byungyoonc/Technik-MIT/Technik-MIT/Technik-MIT.kicad_pcb

## KiCad design Technik-MIT/Technik-MIT.kicad_pcb (2023-05-11)

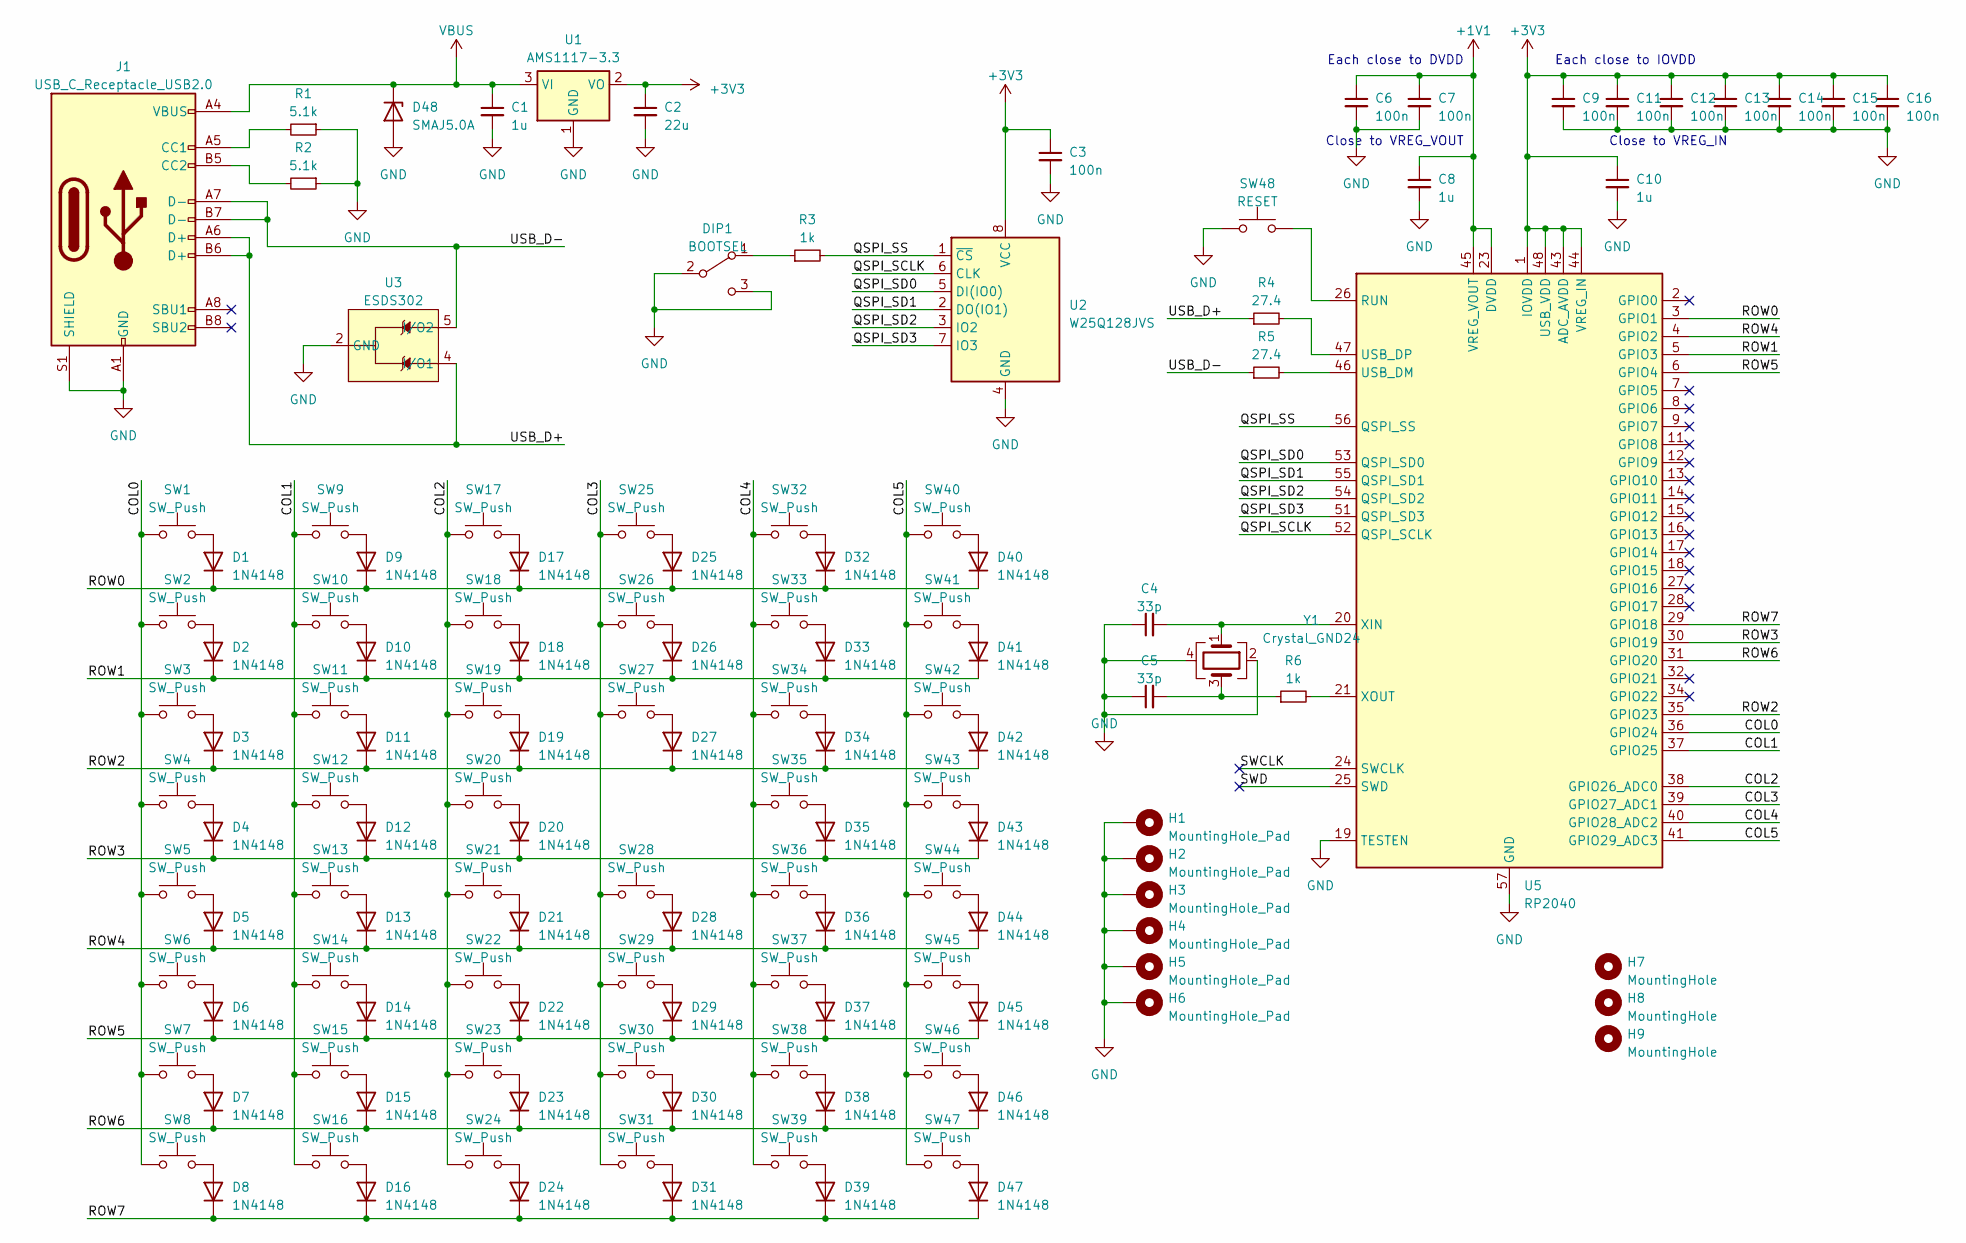
[picture p1: schematic Technik-MIT.kicad_sch]

Parts:
C1, C8, C10: 1u; C_0402_1005Metric
C2: 22u; C_0603_1608Metric
C3, C6, C7, C9, C11, C12, C13, C14, C15, C16: 100n; C_0402_1005Metric
C4, C5: 33p; C_0402_1005Metric
D1, D2, D3, D4, D5, D6, D7, D8, D9, D10, D11, D12, D13, D14, D15, D16, D17, D18, D19, D20, D21, D22, D23, D24, D25, D26, D27, D28, D29, D30, D31, D32, D33, D34, D35, D36, D37, D38, D39, D40, D41, D42, D43, D44, D45, D46, D47: 1N4148; D_SOD-123
D48: SMAJ5.0A; D_SMA; LCSC C2925443
DIP1: BOOTSEL; SW_SPDT_PCM12; LCSC C431541
H1, H2, H3, H4, H5, H6: MountingHole_Pad; Standoff_Hole
H7, H8, H9: MountingHole; Tooling Hole
J1: USB_C_Receptacle_USB2.0; Molex-216990_GCT-USB45xx_HRO-TYPE-C-31-M-13x; LCSC C3019717
R1, R2: 5.1k; R_0402_1005Metric
R3, R6: 1k; R_0402_1005Metric
R4, R5: 27.4; R_0603_1608Metric
SW1, SW2, SW3, SW4, SW5, SW6, SW7, SW8, SW9, SW10, SW11, SW12, SW13, SW14, SW15, SW16, SW17, SW18, SW19, SW20, SW21, SW22, SW23, SW24, SW25, SW26, SW27, SW28, SW29, SW30, SW31, SW32, SW33, SW34, SW35, SW36, SW37, SW38, SW39, SW41, SW42, SW43, SW45, SW46, SW47: SW_Push; ChocV1_Hotswap
SW40: SW_Push; ChocV1_Hotswap_WO_UpperRight
SW44: SW_Push; ChocV1_Hotswap_WO_UpperLeft
SW48: RESET; SW_SPST_TL3342; LCSC C318884
U1: AMS1117-3.3; SOT-223-3_TabPin2
U2: W25Q128JVS; SOIC-8_5.23x5.23mm_P1.27mm; LCSC C97521
U3: ESDS302; SOT-23-5
U5: RP2040; QFN-56-1EP_7x7mm_P0.4mm_EP3.2x3.2mm
Y1: Crystal_GND24; Crystal_SMD_3225-4Pin_3.2x2.5mm; LCSC C9002

Connections:
+1V1: C6.1, C7.1, C8.1, U5.23 (DVDD), U5.45 (VREG_VOUT), U5.50 (DVDD)
+3V3: C2.1, C3.1, C9.1, C10.1, C11.1, C12.1, C13.1, C14.1, C15.1, C16.1, U1.2 (VO), U2.8 (VCC), U5.1 (IOVDD), U5.10 (IOVDD), U5.22 (IOVDD), U5.33 (IOVDD), U5.42 (IOVDD), U5.43 (ADC_AVDD), U5.44 (VREG_IN), U5.48 (USB_VDD), U5.49 (IOVDD)
/COL0: SW1.1, SW2.1, SW3.1, SW4.1, SW5.1, SW6.1, SW7.1, SW8.1, U5.36 (GPIO24)
/COL1: SW9.1, SW10.1, SW11.1, SW12.1, SW13.1, SW14.1, SW15.1, SW16.1, U5.37 (GPIO25)
/COL2: SW17.1, SW18.1, SW19.1, SW20.1, SW21.1, SW22.1, SW23.1, SW24.1, U5.38 (GPIO26_ADC0)
/COL3: SW25.1, SW26.1, SW27.1, SW28.1, SW29.1, SW30.1, SW31.1, U5.39 (GPIO27_ADC1)
/COL4: SW32.1, SW33.1, SW34.1, SW35.1, SW36.1, SW37.1, SW38.1, SW39.1, U5.40 (GPIO28_ADC2)
/COL5: SW40.1, SW41.1, SW42.1, SW43.1, SW44.1, SW45.1, SW46.1, SW47.1, U5.41 (GPIO29_ADC3)
/QSPI_SCLK: U2.6 (CLK), U5.52 (QSPI_SCLK)
/QSPI_SD0: U2.5 (DI(IO0)), U5.53 (QSPI_SD0)
/QSPI_SD1: U2.2 (DO(IO1)), U5.55 (QSPI_SD1)
/QSPI_SD2: U2.3 (IO2), U5.54 (QSPI_SD2)
/QSPI_SD3: U2.7 (IO3), U5.51 (QSPI_SD3)
/QSPI_SS: R3.2, U2.1 (~CS), U5.56 (QSPI_SS)
/ROW0: D1.1 (K), D9.1 (K), D17.1 (K), D25.1 (K), D32.1 (K), D40.1 (K), U5.3 (GPIO1)
/ROW1: D2.1 (K), D10.1 (K), D18.1 (K), D26.1 (K), D33.1 (K), D41.1 (K), U5.5 (GPIO3)
/ROW2: D3.1 (K), D11.1 (K), D19.1 (K), D27.1 (K), D34.1 (K), D42.1 (K), U5.35 (GPIO23)
/ROW3: D4.1 (K), D12.1 (K), D20.1 (K), D35.1 (K), D43.1 (K), U5.30 (GPIO19)
/ROW4: D5.1 (K), D13.1 (K), D21.1 (K), D28.1 (K), D36.1 (K), D44.1 (K), U5.4 (GPIO2)
/ROW5: D6.1 (K), D14.1 (K), D22.1 (K), D29.1 (K), D37.1 (K), D45.1 (K), U5.6 (GPIO4)
/ROW6: D7.1 (K), D15.1 (K), D23.1 (K), D30.1 (K), D38.1 (K), D46.1 (K), U5.31 (GPIO20)
/ROW7: D8.1 (K), D16.1 (K), D24.1 (K), D31.1 (K), D39.1 (K), D47.1 (K), U5.29 (GPIO18)
/SWCLK: U5.24 (SWCLK)
/SWD: U5.25 (SWD)
/USB_D+: J1.A6 (D+), J1.B6 (D+), R4.1, U3.3 (NC), U3.4 (I/O1)
/USB_D-: J1.A7 (D-), J1.B7 (D-), R5.1, U3.1 (NC), U3.5 (I/O2)
GND: C1.2, C2.2, C3.2, C4.1, C5.1, C6.2, C7.2, C8.2, C9.2, C10.2, C11.2, C12.2, C13.2, C14.2, C15.2, C16.2, D48.2 (A), DIP1.2 (B), DIP1.3 (C), H1.1, H2.1, H3.1, H4.1, H5.1, H6.1, J1.A1 (GND), J1.A12 (GND), J1.B1 (GND), J1.B12 (GND), J1.S1 (SHIELD), R1.1, R2.1, SW48.1, U1.1 (GND), U2.4 (GND), U3.2 (GND), U5.19 (TESTEN), U5.57 (GND), Y1.2, Y1.4; also elsewhere on the board
unnamed: C5.2, R6.1, Y1.3
unnamed: D1.2 (A), SW1.2
unnamed: D2.2 (A), SW2.2
unnamed: D3.2 (A), SW3.2
unnamed: D4.2 (A), SW4.2
unnamed: D5.2 (A), SW5.2
unnamed: D6.2 (A), SW6.2
unnamed: D7.2 (A), SW7.2
unnamed: D8.2 (A), SW8.2
unnamed: D9.2 (A), SW9.2
unnamed: D10.2 (A), SW10.2
unnamed: D11.2 (A), SW11.2
unnamed: D12.2 (A), SW12.2
unnamed: D13.2 (A), SW13.2
unnamed: D14.2 (A), SW14.2
unnamed: D15.2 (A), SW15.2
unnamed: D16.2 (A), SW16.2
unnamed: D17.2 (A), SW17.2
unnamed: D18.2 (A), SW18.2
unnamed: D19.2 (A), SW19.2
unnamed: D20.2 (A), SW20.2
unnamed: D21.2 (A), SW21.2
unnamed: D22.2 (A), SW22.2
unnamed: D23.2 (A), SW23.2
unnamed: D24.2 (A), SW24.2
unnamed: D25.2 (A), SW25.2
unnamed: D26.2 (A), SW26.2
unnamed: D27.2 (A), SW27.2
unnamed: D28.2 (A), SW28.2
unnamed: D29.2 (A), SW29.2
unnamed: D30.2 (A), SW30.2
unnamed: D31.2 (A), SW31.2
unnamed: D32.2 (A), SW32.2
unnamed: D33.2 (A), SW33.2
unnamed: D34.2 (A), SW34.2
unnamed: D35.2 (A), SW35.2
unnamed: D36.2 (A), SW36.2
unnamed: D37.2 (A), SW37.2
unnamed: D38.2 (A), SW38.2
unnamed: D39.2 (A), SW39.2
unnamed: D40.2 (A), SW40.2
unnamed: D41.2 (A), SW41.2
unnamed: D42.2 (A), SW42.2
unnamed: D43.2 (A), SW43.2
unnamed: D44.2 (A), SW44.2
unnamed: D45.2 (A), SW45.2
unnamed: D46.2 (A), SW46.2
unnamed: D47.2 (A), SW47.2
unnamed 75: DIP1.1 (A), R3.1; also elsewhere on the board
unnamed: J1.A5 (CC1), R1.2
unnamed: J1.B5 (CC2), R2.2
unnamed 78: SW48.2, U5.26 (RUN); also elsewhere on the board
unnamed: R5.2, U5.46 (USB_DM)
unnamed: R4.2, U5.47 (USB_DP)
unnamed: C4.2, U5.20 (XIN), Y1.1
unnamed: R6.2, U5.21 (XOUT)
VBUS: C1.1, D48.1 (K), J1.A4 (VBUS), J1.A9 (VBUS), J1.B4 (VBUS), J1.B9 (VBUS), U1.3 (VI)

Notes on the sheet:
Close to VREG_VOUT
Close to VREG_IN
Each close to DVDD
Each close to IOVDD

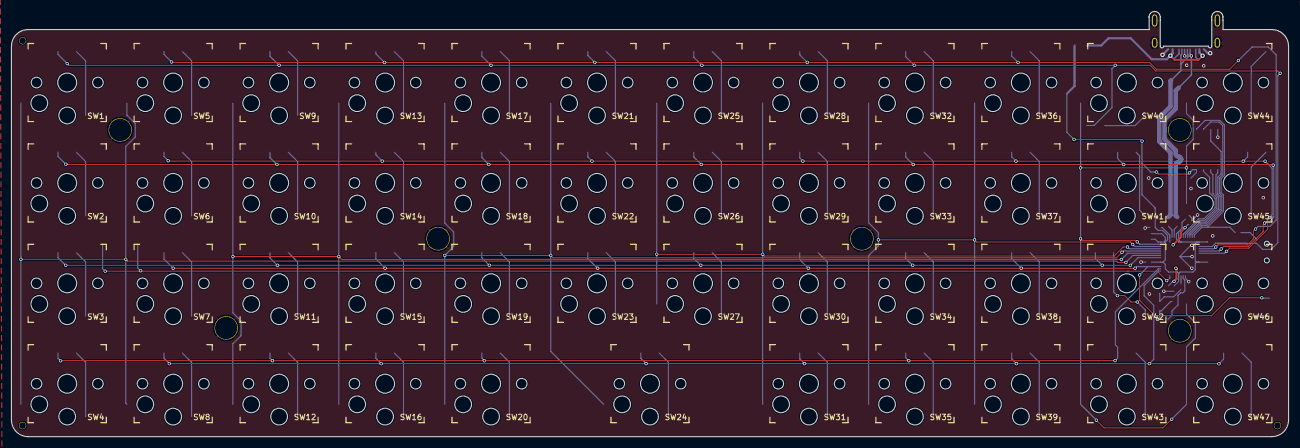
[picture p2: board Technik-MIT.kicad_pcb from above]

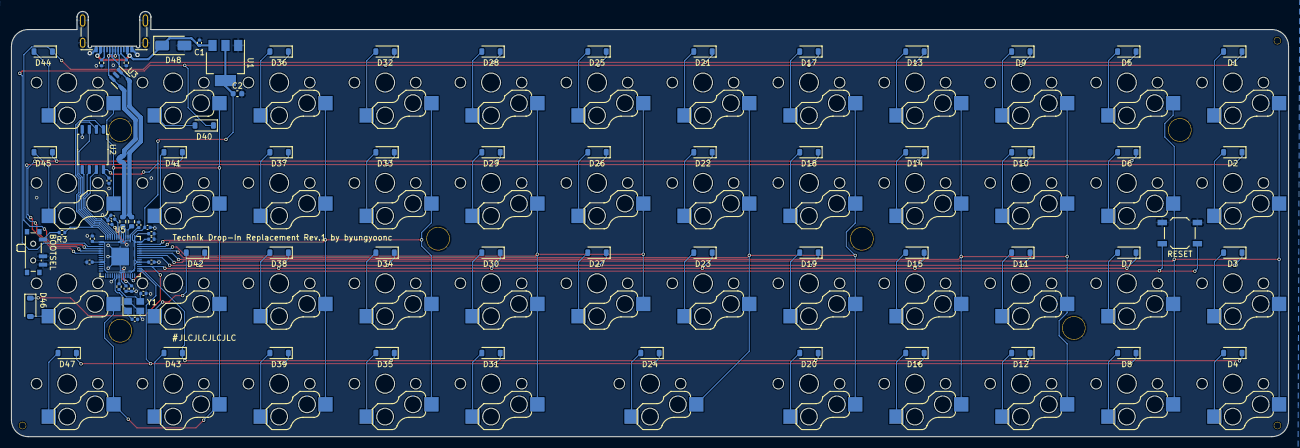
[picture p3: board Technik-MIT.kicad_pcb from below]

Board: 2 copper layers, 229.0 x 76.3 mm, 134 parts (78 on the bottom side), 82 nets.

Other parts of the board:
BOOTSEL: BOOTSEL; SW_SPDT_PCM12
RESET: RESET; SW_SPST_TL3342

Their connections:
GND: BOOTSEL.2 (B), BOOTSEL.3 (C), RESET.1; also elsewhere on the board
unnamed 75: BOOTSEL.1 (A); also elsewhere on the board
unnamed 78: RESET.2; also elsewhere on the board
