byungyoonc/Technik-MIT/(commit log)

2023-03-19 Initialize KiCad project
    [Technik-MIT.kicad_pcb, Technik-MIT.kicad_sch]
2023-03-22 Update PCB schematics
    [Technik-MIT.kicad_sch]
2023-03-23 Update PCB schematics (again)
    [Technik-MIT.kicad_sch]
2023-03-24 Update PCB schematic
    [Technik-MIT.kicad_sch]
2023-03-24 Update PCB
    [Technik-MIT.kicad_pcb, Technik-MIT.kicad_sch]
2023-03-27 Working on PCB
    [Technik-MIT.kicad_pcb, Technik-MIT.kicad_sch]
2023-04-09 Update PCB
    Change spacing from MX to Choc
    [Technik-MIT.kicad_pcb, Technik-MIT.kicad_sch]
2023-04-10 Update ChocV1_Hotswap footprint
    [Technik-MIT.kicad_pcb]
2023-04-13 Update PCB to match preexisting mounting holes
    [Technik-MIT.kicad_pcb, Technik-MIT.kicad_sch]
2023-04-13 Update some of the silkscreen
    [Technik-MIT.kicad_pcb]
2023-04-16 Update fabrication export settings
    Alongside with some minor trace update
    [Technik-MIT.kicad_pcb]
2023-04-17 Add tooling holes, JLC order number silkscreen.
    [Technik-MIT.kicad_pcb, Technik-MIT.kicad_sch]
2023-04-30 Finalizing PCB layout for print
    [Technik-MIT.kicad_pcb, Technik-MIT.kicad_sch]
2023-05-10 Changed PCB layout & schematics for cheaper production at JLCPCB
    Used available basic parts alternatives
    [Technik-MIT.kicad_pcb, Technik-MIT.kicad_sch]
2023-05-10 Adjusted silkscreen position
    [Technik-MIT.kicad_pcb]
2023-05-11 Updated PCB layout to avoid interferences
    [Technik-MIT.kicad_pcb]
2023-05-11 Added top plate project files
    [top-plate.kicad_pcb, top-plate.kicad_sch]
